robsva/maxiv-huzzah32dds/schematic/R1003_Huzzah32DDS.kicad_pcb

## KiCad design schematic/R1003_Huzzah32DDS.kicad_pcb (2021-01-08)

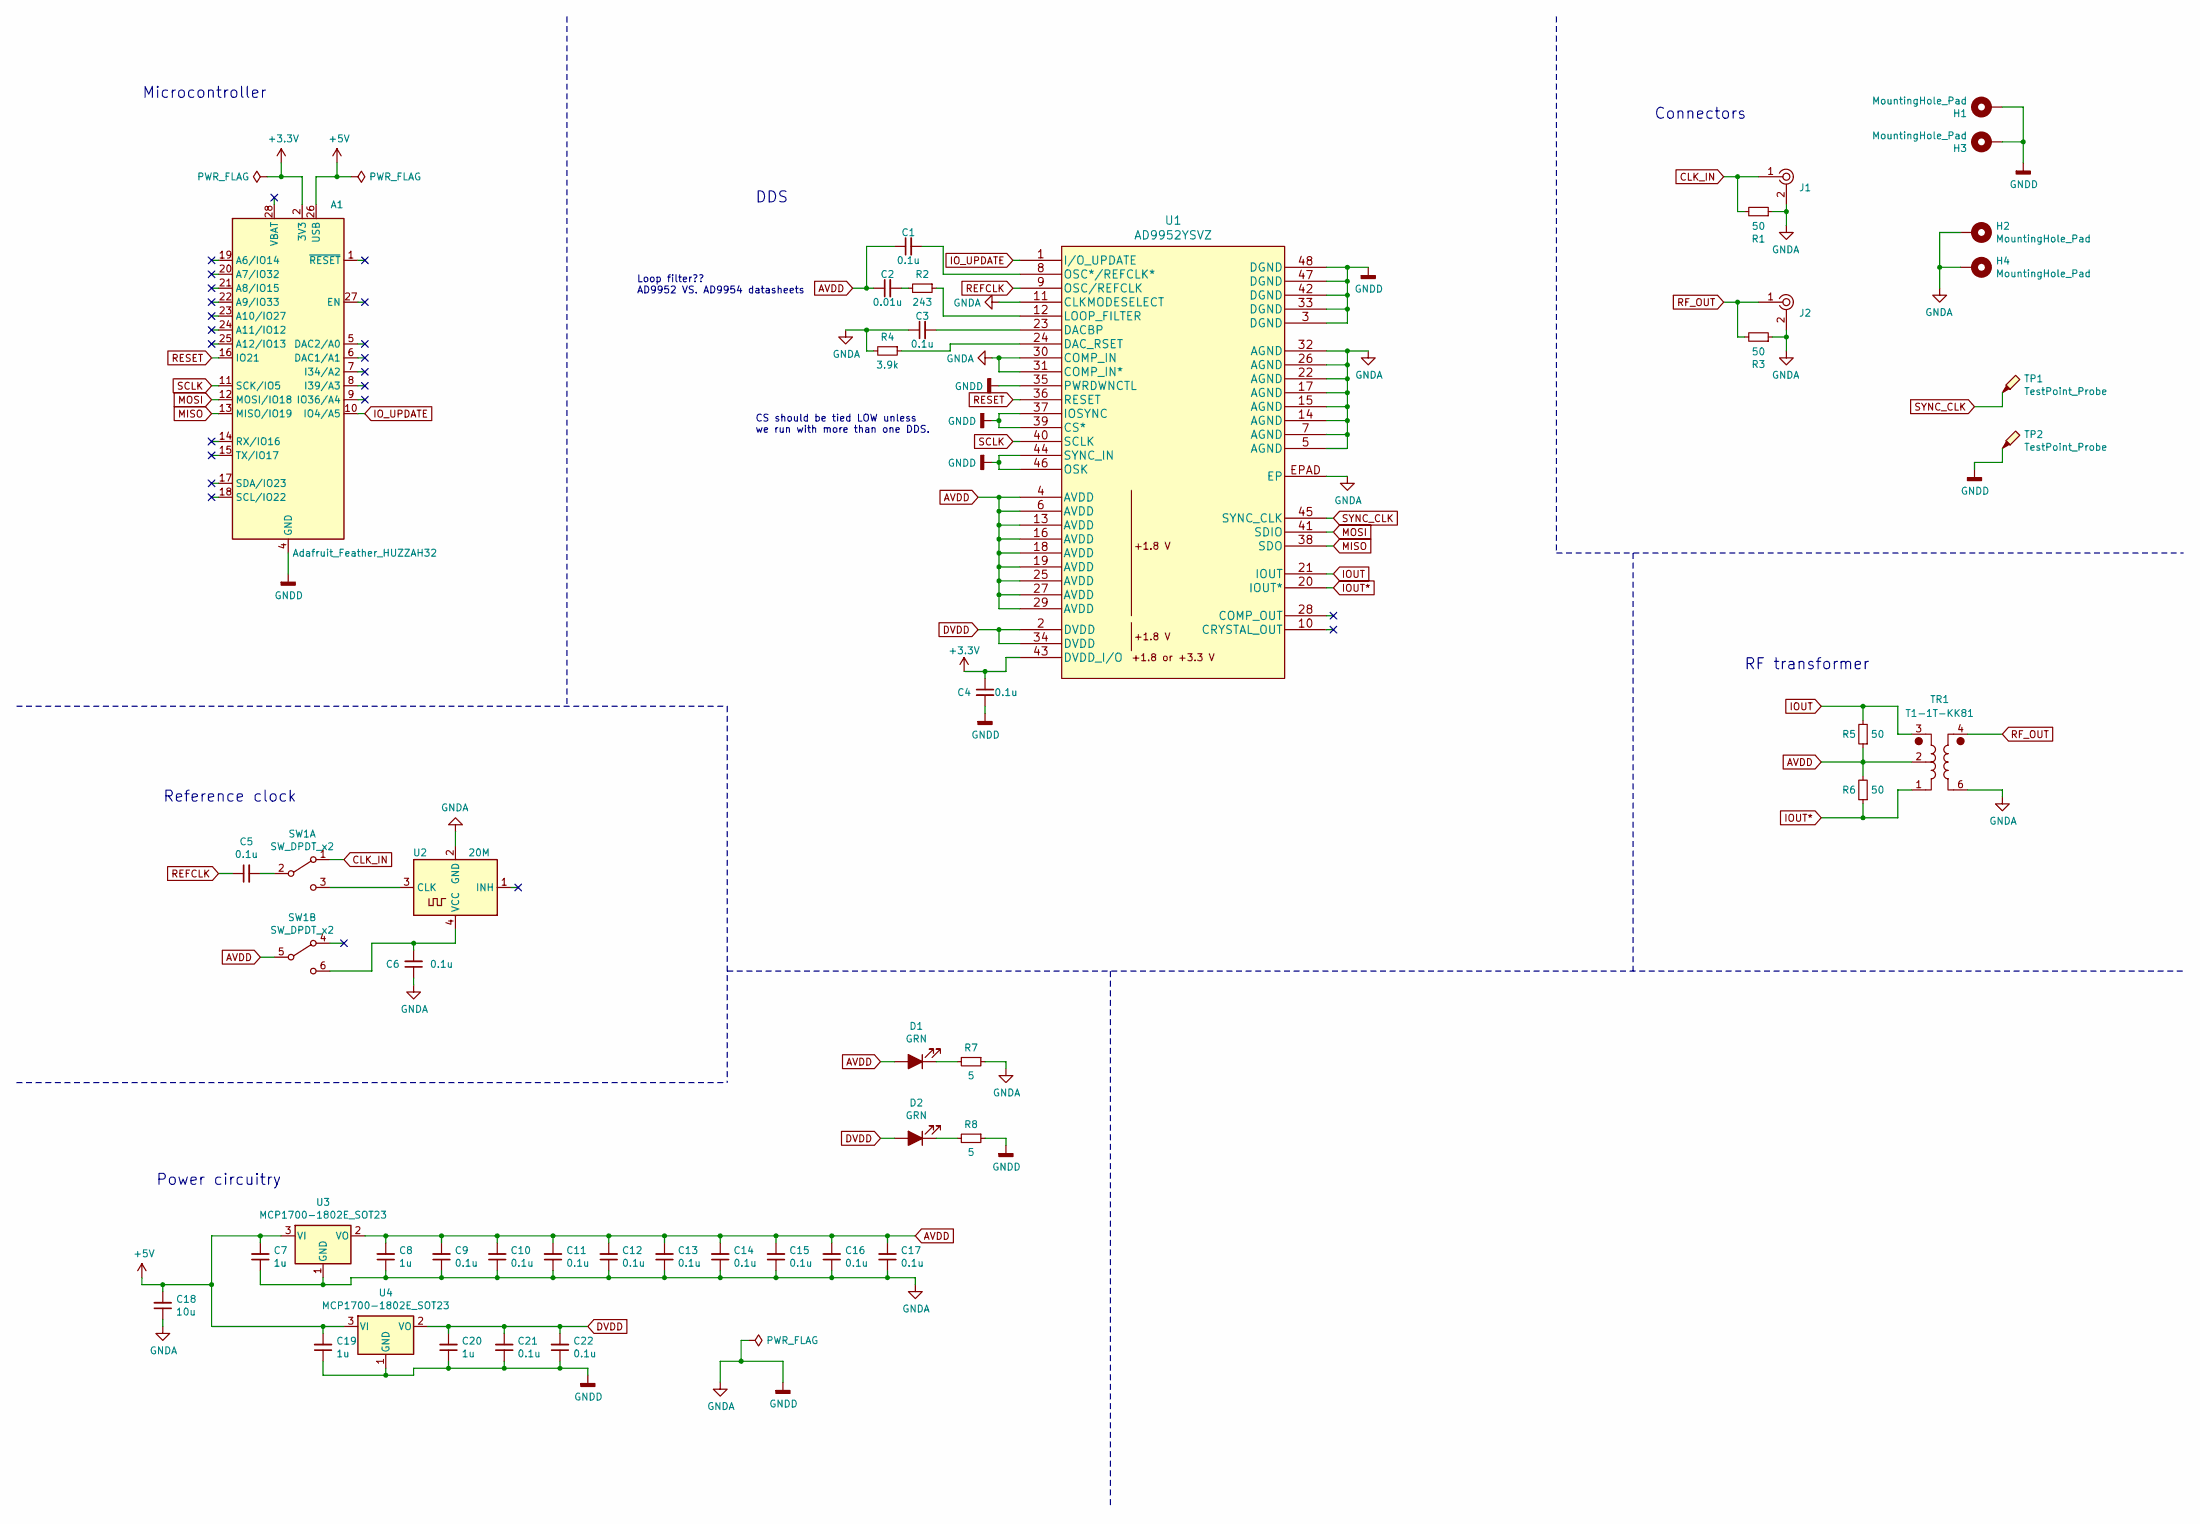
[picture p1: schematic R1003_Huzzah32DDS.sch, Adafruit Feather Huzzah32 DDS]

Parts:
A1: Adafruit_Feather_HUZZAH32; Adafruit_Feather
C1, C3, C4, C5, C6, C9, C10, C11, C12, C13, C14, C15, C16, C17, C21, C22: 0.1u; C_0805_2012Metric_Pad1.18x1.45mm_HandSolder
C2: 0.01u; C_0805_2012Metric_Pad1.18x1.45mm_HandSolder
C7, C8, C19, C20: 1u; C_1206_3216Metric_Pad1.33x1.80mm_HandSolder
C18: 10u; C_1206_3216Metric_Pad1.33x1.80mm_HandSolder
D1, D2: GRN; LED_0603_1608Metric_Pad1.05x0.95mm_HandSolder
H1, H2, H3, H4: MountingHole_Pad; MountingHole_3.2mm_M3_Pad_Via
J1, J2: 142-0701-801; RF_SMA_BoardEdge_142-0701-801; MPN 142-0701-801; Digi-Key_PN J502-ND
R1, R3, R5, R6: 50; R_0805_2012Metric_Pad1.20x1.40mm_HandSolder
R2: 243; R_1206_3216Metric_Pad1.30x1.75mm_HandSolder
R4: 3.9k; R_1206_3216Metric_Pad1.30x1.75mm_HandSolder
R7, R8: 5; R_0805_2012Metric_Pad1.20x1.40mm_HandSolder
SW1: SW_DPDT_x2; SW_CuK_JS202011CQN_DPDT_Straight
TP1, TP2: TestPoint_Probe; TestPoint_Loop_D2.50mm_Drill1.0mm
TR1: T1-1T-KK81; Mini-Circuits_T1-1T-KK81
U1: AD9952YSVZ
U2: 20M; Crystal_SMD_2016-4Pin_2.0x1.6mm
U3, U4: MCP1700-1802E_SOT23; SOT-23

Connections:
+3V3: A1.2 (3V3), C4.1, U1.43 (DVDD_I/O)
+5V: A1.26 (USB), C7.2, C18.2, C19.2, U3.3 (VI), U4.3 (VI)
AVDD: C1.1, C2.1, C8.2, C9.2, C10.2, C11.2, C12.2, C13.2, C14.2, C15.2, C16.2, C17.2, D1.2 (A), R5.1, R6.2, SW1.5 (B), TR1.2 (SEC_CT), U1.4 (AVDD), U1.6 (AVDD), U1.13 (AVDD), U1.16 (AVDD), U1.18 (AVDD), U1.19 (AVDD), U1.25 (AVDD), U1.27 (AVDD), U1.29 (AVDD), U3.2 (VO)
CLK_IN: J1.1, R1.2, SW1.1 (A)
DVDD: C20.2, C21.2, C22.2, D2.2 (A), U1.2 (DVDD), U1.34 (DVDD), U4.2 (VO)
GNDA: A1.4 (GND), C3.1, C4.2, C6.1, C7.1, C8.1, C9.1, C10.1, C11.1, C12.1, C13.1, C14.1, C15.1, C16.1, C17.1, C18.1, C19.1, C20.1, C21.1, C22.1, H1.1, H2.1, H3.1, H4.1, J1.2, J2.2, R1.1, R3.1, R4.2, R7.1, R8.1, TP2.1, TR1.6 (PRI), U1.3 (DGND), U1.5 (AGND), U1.7 (AGND), U1.11 (CLKMODESELECT), U1.14 (AGND), U1.15 (AGND), U1.17 (AGND), U1.22 (AGND), U1.26 (AGND), U1.30 (COMP_IN), U1.31 (COMP_IN*), U1.32 (AGND), U1.33 (DGND), U1.35 (PWRDWNCTL), U1.37 (IOSYNC), U1.39 (CS*), U1.42 (DGND), U1.44 (SYNC_IN), U1.46 (OSK), U1.47 (DGND), U1.48 (DGND), U1.EPAD (EP), U2.2 (GND), U3.1 (GND), U4.1 (GND)
IOUT: R5.2, TR1.3 (SEC_DOT), U1.21 (IOUT)
IOUT*: R6.1, TR1.1 (SEC), U1.20 (IOUT*)
IO_UPDATE: A1.10 (IO4/A5), U1.1 (I/O_UPDATE)
MISO: A1.13 (MISO/IO19), U1.38 (SDO)
MOSI: A1.12 (MOSI/IO18), U1.41 (SDIO)
unnamed: C1.2, U1.8 (OSC*/REFCLK*)
unnamed: C2.2, R2.2
unnamed: C3.2, U1.23 (DACBP)
unnamed: C5.2, SW1.2 (B)
unnamed: C6.2, SW1.6 (C), U2.4 (VCC)
unnamed: D1.1 (K), R7.2
unnamed: D2.1 (K), R8.2
unnamed: R2.1, U1.12 (LOOP_FILTER)
unnamed: R4.1, U1.24 (DAC_RSET)
unnamed: SW1.3 (C), U2.3 (CLK)
REFCLK: C5.1, U1.9 (OSC/REFCLK)
RESET: A1.16 (IO21), U1.36 (RESET)
RF_OUT: J2.1, R3.2, TR1.4 (PRI_DOT)
SCLK: A1.11 (SCK/IO5), U1.40 (SCLK)
SYNC_CLK: TP1.1, U1.45 (SYNC_CLK)

Notes on the sheet:
Connectors
Microcontroller
DDS
RF transformer
Power circuitry
Loop filter?? AD9952 VS. AD9954 datasheets
CS should be tied LOW unless we run with more than one DDS.
Reference clock

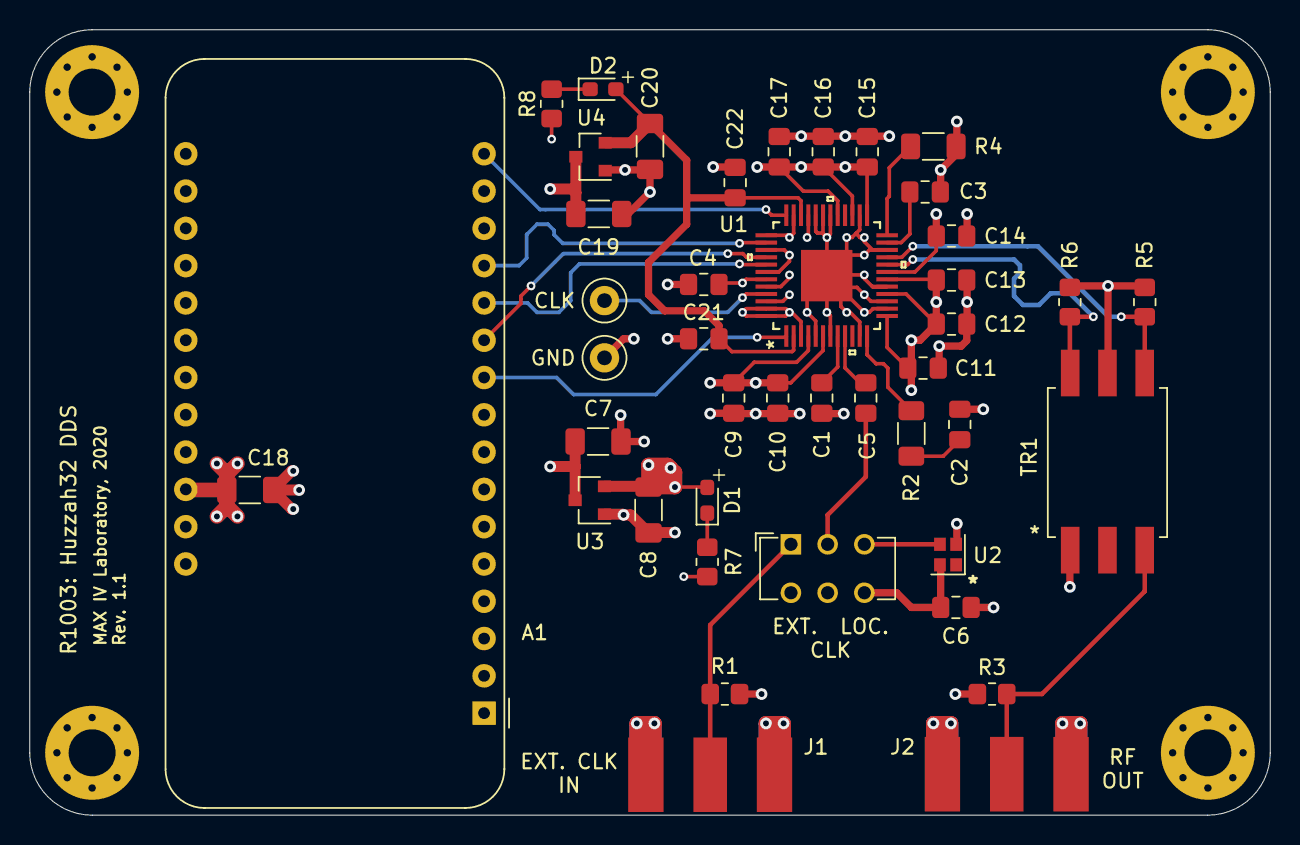
[picture p2: board R1003_Huzzah32DDS.kicad_pcb from above]

Board: 4 copper layers, 84.5 x 53.5 mm, 47 parts (0 on the bottom side), 26 nets.
